elliotmiles/wheely-dan/component-interfacing-diagram.png

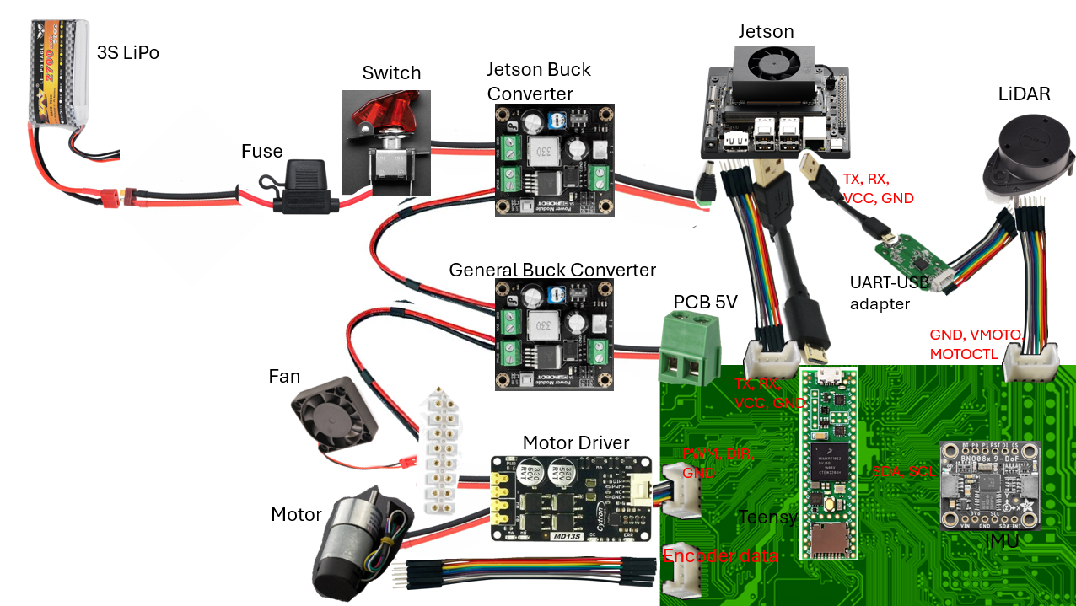
component-interfacing-diagram.png
