elliotmiles/wheely-dan/blog/1. PCB Design.md

# 05/03/2026 - PCB Design

I used KiCad for the PCB design simply because it is free and widely used. The PCB acts as a hub for the robot, despite only containing the MCU and IMU onboard. All off-board connections are centered around grove headers. This means that all "logic" (low current) connections will be grove wires, allowing easy distinction between high-current and low-current carrying wires.

## Schematic

I found the symbol for the Teensy online, and made the symbol for the IMU myself. I found symbols for the grove connectors online, and the symbol representing the screw terminal for the board's 5V power rail is a generic connector. 

Instead of wiring all GND pins together, I connected all GND pins to the dedicated GND symbol. This is so that I can create a "ground pour", where all the empty space on a layer is connected to GND, which is ideal because it means that all GND connections share a low impedance. 



## PCB layout

I opted to go with a two-layer PCB simply because the board is not very large and so two layers is sufficient.
