elliotmiles/wheely-dan/frames_2026-03-25_01.47.09.pdf

view_frames Result

Recorded at time: 1774403229.2972925

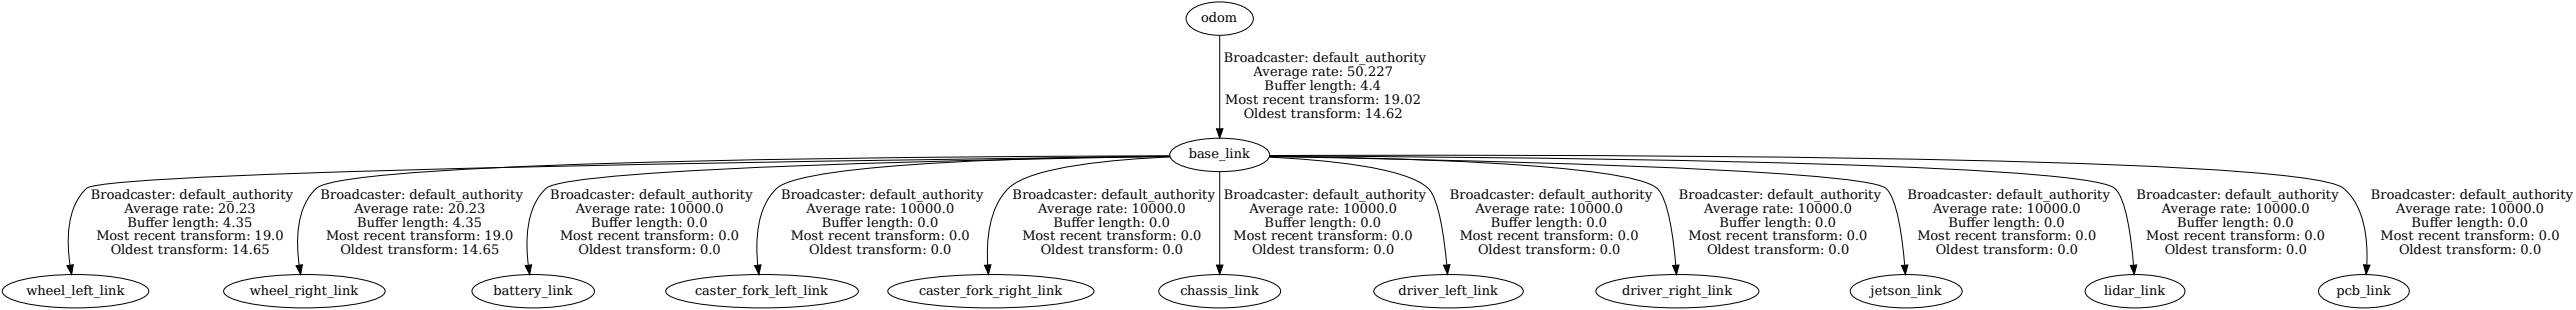
[picture p2: figure]
odom; base_link; Broadcaster: default_authority Average rate: 50.227 Buffer length: 4.4 Most recent transform: 19.02 Oldest transform: 14.62; wheel_left_link; Broadcaster: default_authority Average rate: 20.23 Buffer length: 4.35 Most recent transform: 19.0 Oldest transform: 14.65; wheel_right_link; battery_link; Broadcaster: default_authority Average rate: 10000.0 Buffer length: 0.0 Most recent transform: 0.0 Oldest transform: 0.0; caster_fork_left_link; caster_fork_right_link; chassis_link; driver_left_link; driver_right_link; jetson_link; lidar_link; pcb_link
