elliotmiles/wheely-dan/block-diagram.png

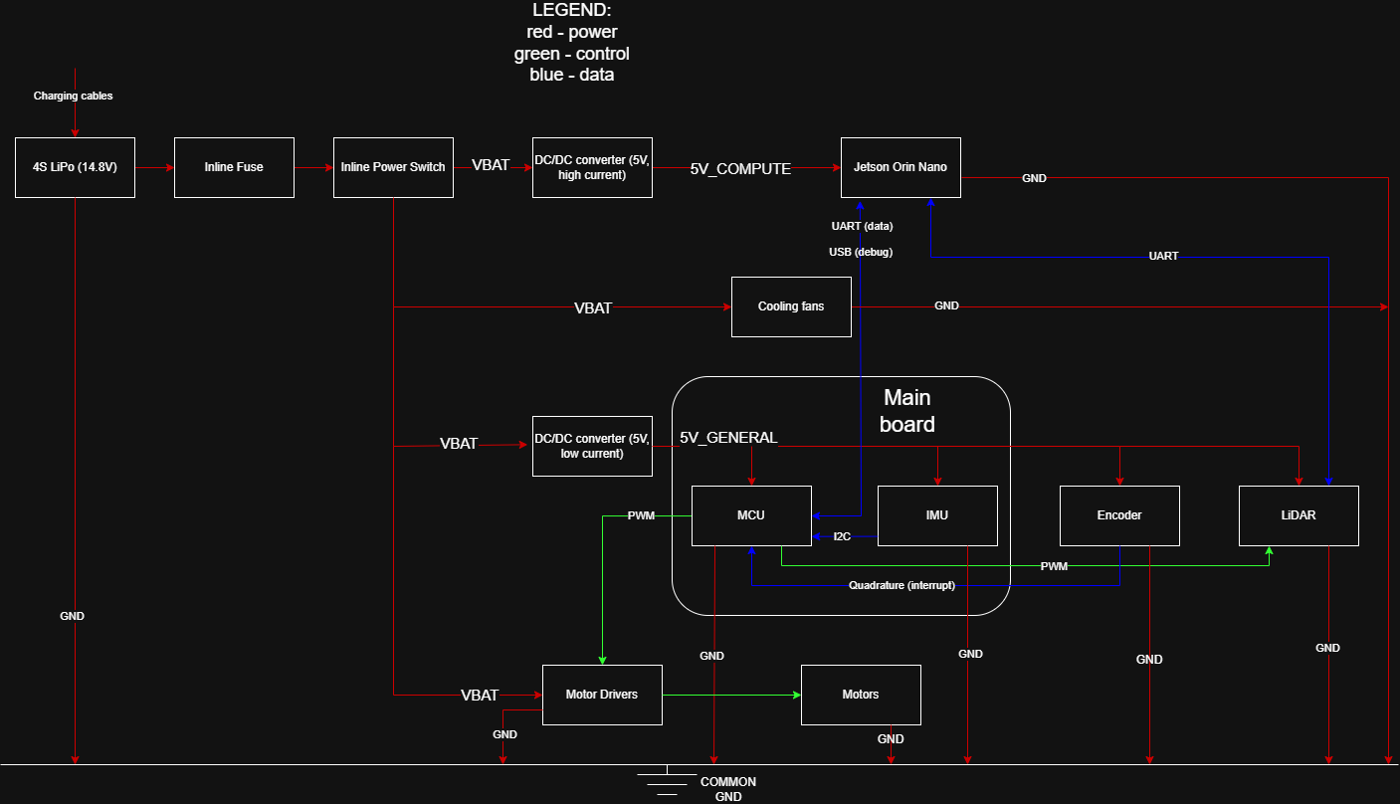
block-diagram.png
