elliotmiles/wheely-dan/hardware-block-diagram.png

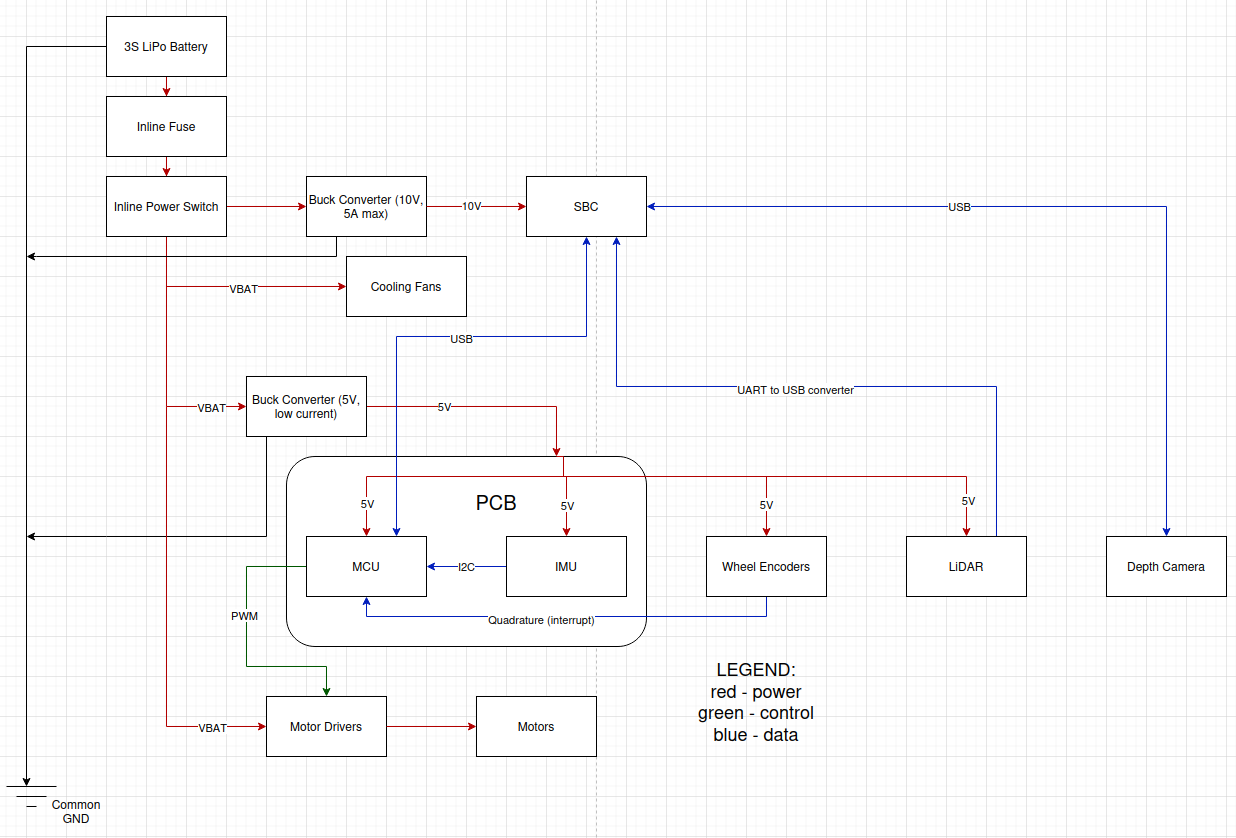
hardware-block-diagram.png
