elliotmiles/wheely-dan/src/wd_control/config/controllers.yaml

controller_manager:
  ros__parameters:
    update_rate: 30

    diff_cont:
      type: diff_drive_controller/DiffDriveController

    joint_broad:
      type: joint_state_broadcaster/JointStateBroadcaster

diff_cont:
  ros__parameters:

    publish_rate: 50.0

    base_frame_id: base_link

    left_wheel_names: ['wheel_left_joint']
    right_wheel_names: ['wheel_right_joint']
    wheel_separation: 0.202
    wheel_radius: 0.0325

# joint_broad:
#   ros__parameters:
