elliotmiles/wheely-dan/(commit log)

2026-03-05 Add documentation for PCB design using KiCad
    Documented the PCB design process, including schematic and layout details.
2026-03-19 Update Schematic Design by removing PCB layout section
    Removed PCB layout section and retained schematic image.
2026-03-19 Create 2. PCB Design.md
2026-03-19 Add CAD design documentation for robot
    Documented the design and features of the robot built with Fusion 360, including the structure, components, and future steps for simulation.
2026-03-22 Modify urdf
    [gazebo_control.xacro, inertial_macros.xacro, robot.urdf.xacro, robot_core.xacro, robot_desc.xacro]
2026-03-23 Modify launch files
    [robot_desc.xacro]
2026-03-25 Change torque limit and change Twist type
    [gazebo_control.xacro, robot_desc.xacro]
2026-03-26 Added lidar
    [inertial_macros.xacro, robot_desc.xacro]
2026-03-26 Update Jetson Setup with additional installation steps
    Added installation steps for Firefox, ROS2 Humble, and VSCode, along with SSH instructions for headless operation.
2026-03-27 Create 7. LiDAR Module.md
2026-03-28 Update 2. PCB Design.md
2026-03-28 Clarify motor cable routing for LiDAR module testing
    Rephrased the sentence about routing motor cables for clarity.
2026-03-30 Change xacro files hierarchy
    [gazebo_lidar.xacro, robot.urdf.xacro, robot_desc.xacro]
2026-04-01 Update urdf files for new motor positions
    [gazebo_control.xacro, robot_desc.xacro]
2026-04-01 Add .gitignore and frame diagram
2026-04-16 Add ros2_control for simulation
    [controllers.yaml, gazebo_control.xacro, gazebo_lidar.xacro, robot.urdf.xacro, ros2_control.xacro]
2026-04-17 Added an argument to toggle between use of ros2_control and gz diff drive plugin
    [robot.urdf.xacro]
2026-04-24 WIP gz depth camera
    [gazebo_depth_camera.xacro, robot.urdf.xacro, robot_desc.xacro]
2026-04-25 WIP 3d mapping
    [gazebo_depth_camera.xacro, gazebo_lidar.xacro, robot.urdf.xacro, robot_desc.xacro, sensors.xacro]
2026-04-25 Add depth camera in gz
    [robot_desc.xacro]
2026-04-27 WIP rtabmap
    [sensors.xacro]
2026-05-01 Fix depth camera and add rtabmap
    [robot_desc.xacro, sensors.xacro]
2026-05-02 Add lidar launch file
    [sensors.xacro]
2026-05-14 Update jetson comms node
2026-05-15 Update blog with motor control and SLAM details
    Expanded the blog to include details on motor control, serial communication, and SLAM implementation with ROS2. Added images and explanations of the control loop and navigation setup.
2026-05-17 Add first iteration of motor control loop
2026-05-18 Update PID node
2026-05-18 Add teensy files
2026-05-18 Enhance blog with encoder test and ROS2 node info
    Added details about encoder testing and ROS2 node functionality.
2026-05-19 Change path names for modularity
    [robot_desc.xacro]
2026-05-19 Rearrange xacro files
    [inertial_macros.xacro, robot_desc.xacro, sim_robot.urdf.xacro]
2026-05-19 Update package references
    [sim_robot.urdf.xacro]
2026-05-24 Update blog with depth camera and semantic mapping details
    Added details about incorporating a depth camera plugin and implementing semantic mapping with YOLO for 3D mapping in the blog.
2026-05-25 Add IMU data transmission to teensy code
2026-05-25 Update teensy code to send IMU data
2026-05-25 Change naming of camera links
    [robot_desc.xacro, sensors.xacro]
2026-06-08 Enhance README with communication and future plans
    Added detailed explanations about communication between Jetson and Teensy, controller functionality, and future work plans.
2026-06-14 Enhance blog with semantic mapping and YOLO insights
    Added explanations about semantic mapping and object recognition capabilities of a mapping robot. Updated the blog with insights on YOLO model performance and control loop implementation on Teensy.
2026-07-14 Remove mapping section and update motor control details
    Removed outdated section on mapping and clarified the importance of encoders for motor control.
